SyssouREB/Odin/README.md

# Odin
Robot detecteur et scanner d'obstacle
