SyssouREB/Odin/(commit log)

2018-12-13 Create Rapoort de sc-ance 20_12 REBUFFEL
2018-12-13 Update and rename Rapoort de sc-ance 20_12 REBUFFEL to Raport de seance 20_12 REBUFFEL
2018-12-13 Update Raport de seance 20_12 REBUFFEL
2019-01-11 Update and rename Raport de seance 20_12 REBUFFEL to Raport de seance 13_12 REBUFFEL
2019-01-13 Rename Raport de seance 13_12 REBUFFEL to Aymeric Rebuffel - Rapport 13-12-18
